grobx/unimi-embedded-project/README.md

# Projects

- [ESPerimentinoPID](ESPerimentinoPID/README.md)
