grobx/unimi-embedded-project/ESPerimentinoPID/docs/imgs/gallery/01 - IMG_20220316_195854.jpg

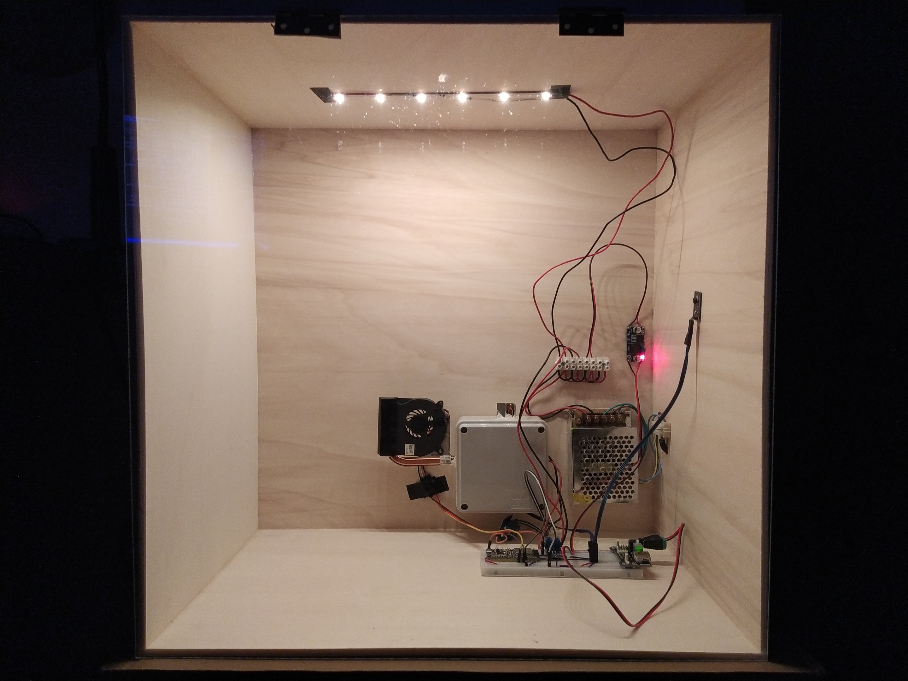
ESPerimentinoPID/docs/imgs/gallery/01 - IMG_20220316_195854.jpg
