grobx/unimi-embedded-project/ESPerimentinoPID/docs/imgs/gallery/02 - IMG_20220316_195306.jpg

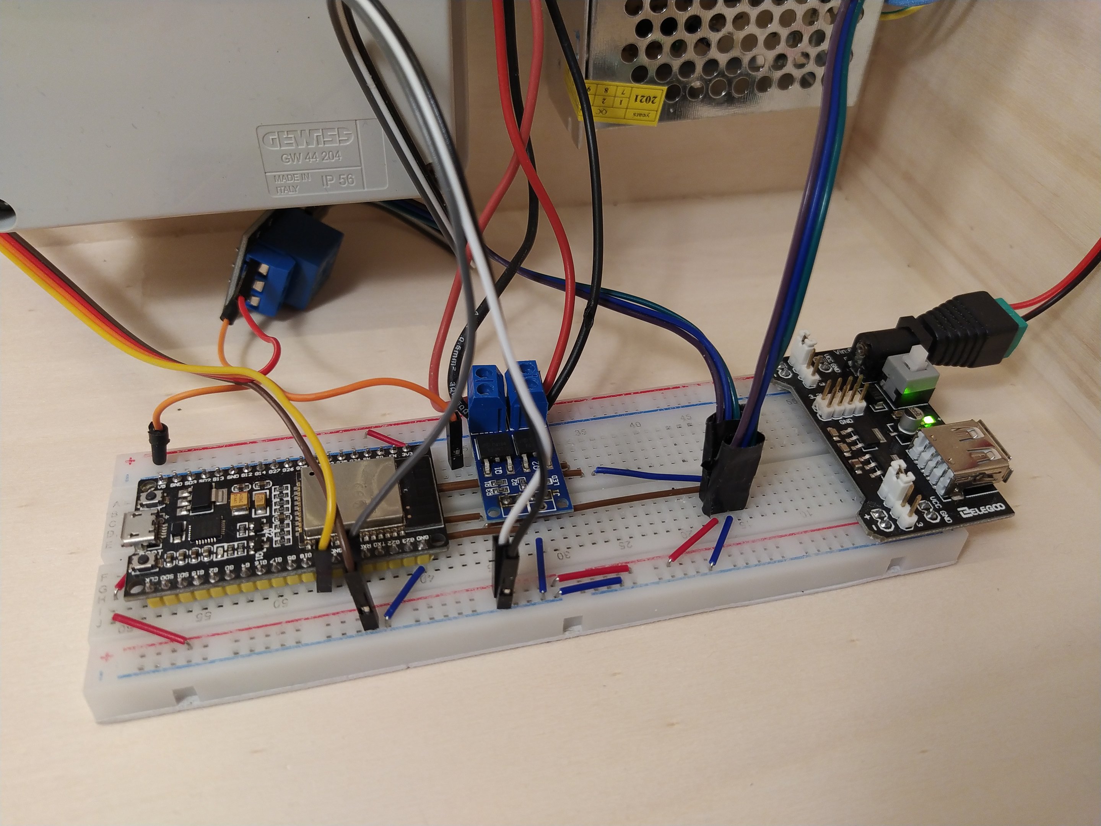
ESPerimentinoPID/docs/imgs/gallery/02 - IMG_20220316_195306.jpg
