grobx/unimi-embedded-project/ESPerimentinoPID/docs/imgs/gallery/03 - 51Dt02Ux9AL._AC_SL1001_.jpg

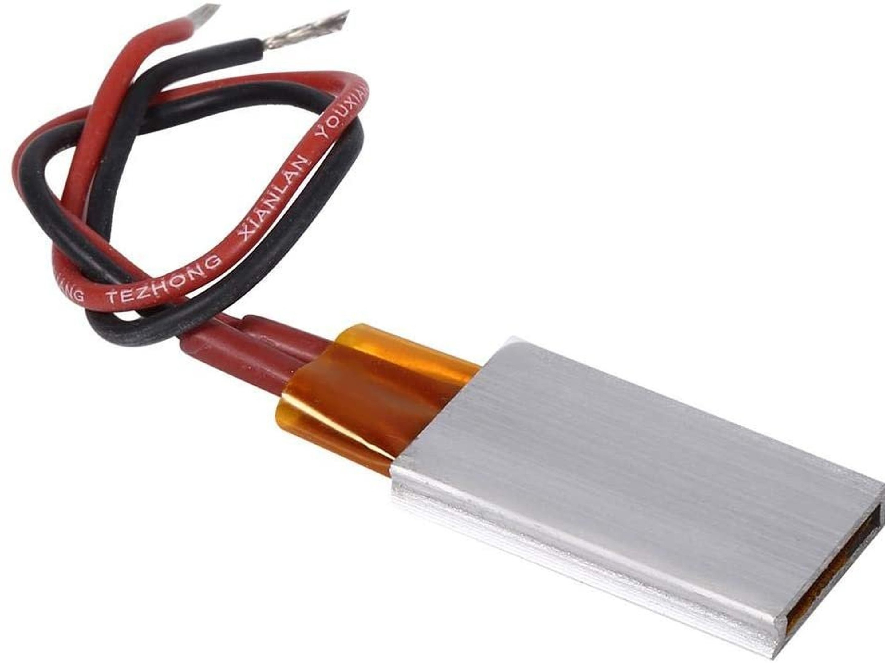
ESPerimentinoPID/docs/imgs/gallery/03 - 51Dt02Ux9AL._AC_SL1001_.jpg
