grobx/unimi-embedded-project/ESPerimentinoPID/docs/imgs/gallery/04 - mpv-shot0002.jpg

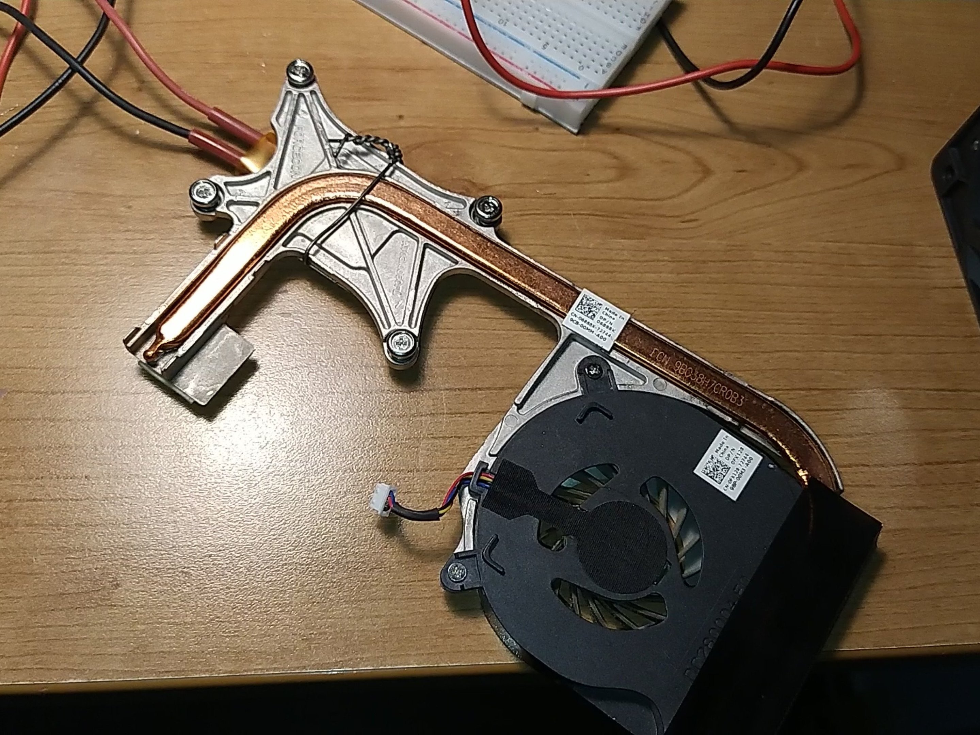
ESPerimentinoPID/docs/imgs/gallery/04 - mpv-shot0002.jpg
