grobx/unimi-embedded-project/ESPerimentinoPID/docs/imgs/gallery/05 - IMG_20220108_134641.jpg

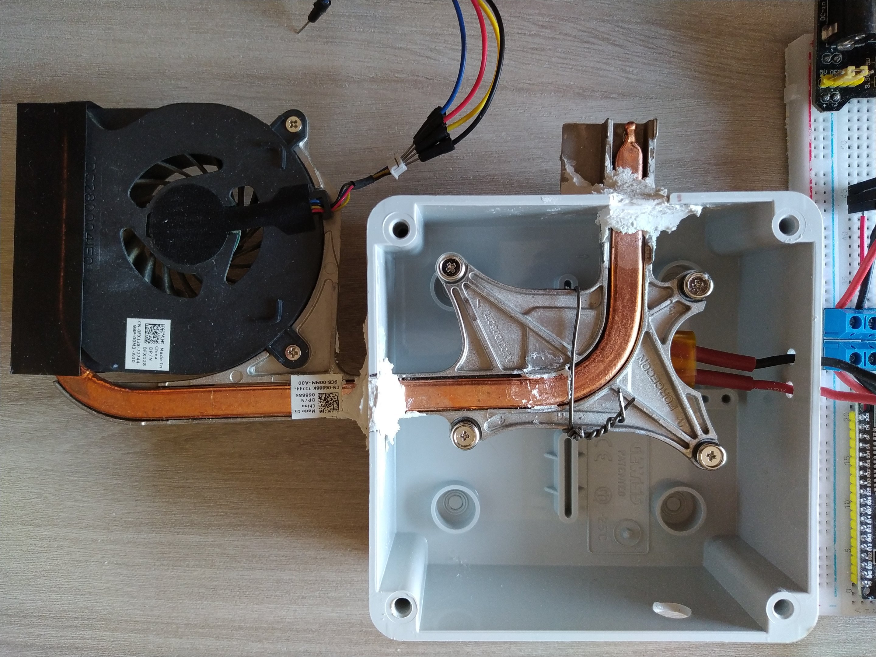
ESPerimentinoPID/docs/imgs/gallery/05 - IMG_20220108_134641.jpg
