grobx/unimi-embedded-project/ESPerimentinoPID/docs/imgs/gallery/06 - IMG_20220108_150710.jpg

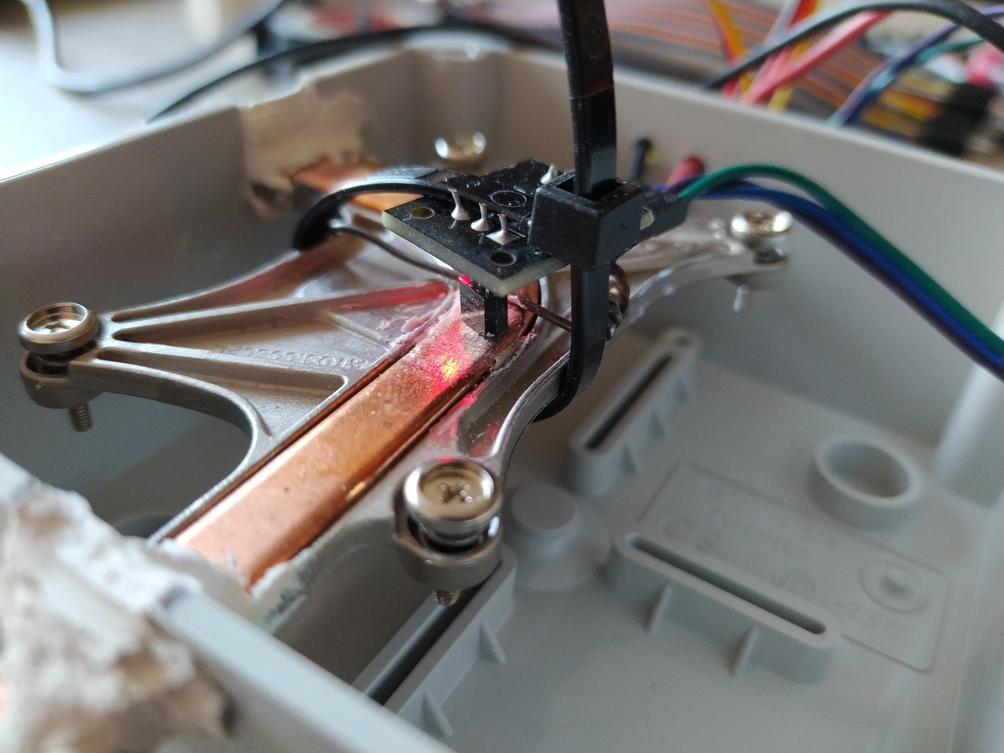
ESPerimentinoPID/docs/imgs/gallery/06 - IMG_20220108_150710.jpg
