grobx/unimi-embedded-project/ESPerimentinoPID/docs/imgs/gallery/07 - IMG_20220316_195656.jpg

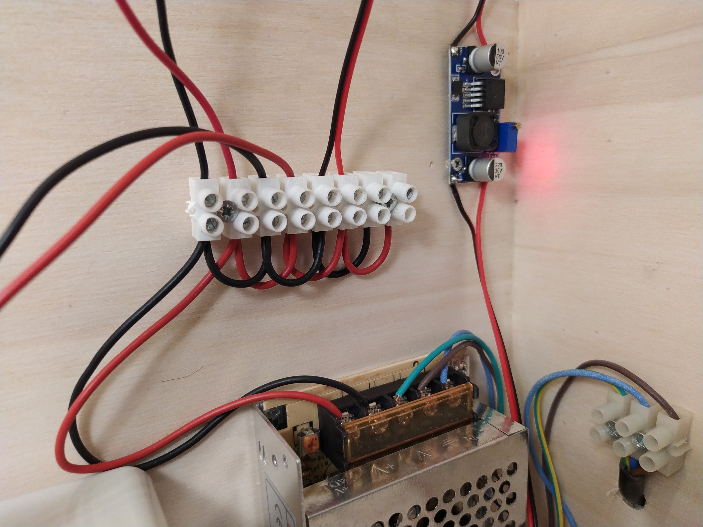
ESPerimentinoPID/docs/imgs/gallery/07 - IMG_20220316_195656.jpg
