grobx/unimi-embedded-project/ESPerimentinoPID/docs/imgs/gallery/08 - IMG_20220316_195444.jpg

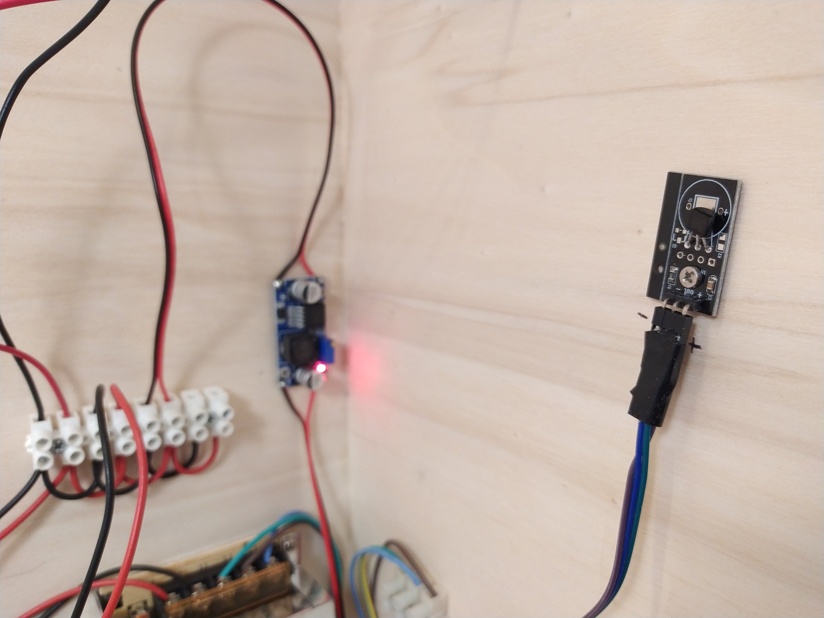
ESPerimentinoPID/docs/imgs/gallery/08 - IMG_20220316_195444.jpg
