grobx/unimi-embedded-project/(list of files, drawings)

Other design files:
ESPerimentinoPID/docs/fritzing/heating system.fzz
