grobx/unimi-embedded-project/(commit log)

2021-12-15 Prima versione controller PID
2021-12-15 Aggiornato testo licenza HeaterPIDRadiant.ino
2021-12-15 Usa isteresi 0.2 °C (a patto che Kp=1,Ki=Kd=0)
    - fix BUG PID, usavo Kp al posto di Kd
    - limita output PID (heat) tra -1.0 e +1.0
2021-12-17 Aggiunto README.md e sistemati parametri PID
2022-01-17 ESPerimentino PID (first version)
2022-01-17 Add fan rpm counter + Handle json setup
2022-03-16 Release 0.2
    Add the option to turn off the PID controller
    - if you specify 0.0 as Kp,Ki,Kd, the related PID will be disabled and it
    uses a simple threshold control (below setpoint it set heat to max,
    and above will see heat to min)
    - add minSetpoint to HeaterConfig
    - extract default ExperimentConfig from MQTTClientLoopTask to LocalConfig.h
    - fix copy&paste bug in MQTTClientLoopTask
    - use QuickPID::Control::automatic as default
    - remove old HeaterPIDRadiant.ino
    - move imgs and fritzing to docs
    Extract MQTTClient from MQTTClientLoopTask
    Useful version of reports and scripts
    Fix bugs
    - in version without PID, when read temp is equals to setpoint
    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
    [esperimentino-2022-03-12-19:59:43.csv, esperimentino-2022-03-12-20:46:36.csv, esperimentino-2022-03-13-00:11:10.csv, esperimentino-2022-03-13-00:56:28.csv, esperimentino-2022-03-13-01:41:20.csv, esperimentino-2022-03-13-02:18:26.csv, esperimentino-2022-03-13-03:06:09.csv, esperimentino-2022-03-13-14:09:58.csv]
2022-03-17 Aggiornato README.md
    [heating system.fzz]
2026-04-30 reports moved to https://github.com/grobx/unimi-embedded-project-report.git
    [esperimentino-2022-03-12-19:59:43.csv, esperimentino-2022-03-12-20:46:36.csv, esperimentino-2022-03-13-00:11:10.csv, esperimentino-2022-03-13-00:56:28.csv, esperimentino-2022-03-13-01:41:20.csv, esperimentino-2022-03-13-02:18:26.csv, esperimentino-2022-03-13-03:06:09.csv, esperimentino-2022-03-13-14:09:58.csv]
